makerbase-mks/MKS-SERVO57C/Shell file/shell-1.STL

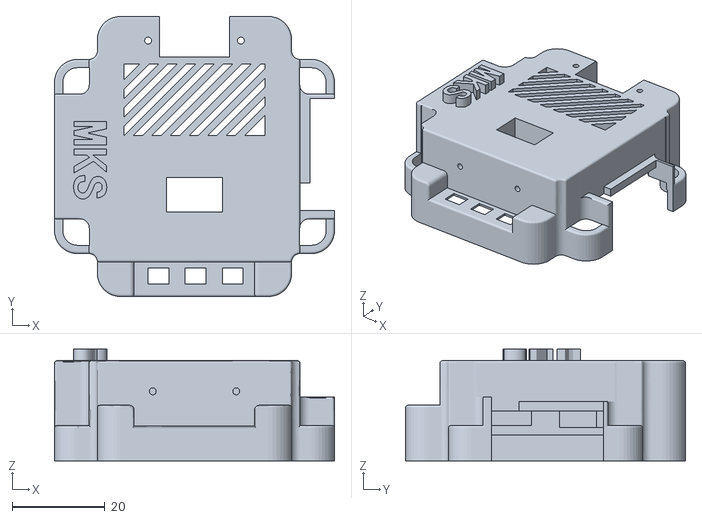
[picture p1: CAD file, 2022-12-19]
Shell file/shell-1.STL
60.4 x 60.4 x 24.1
