makerbase-mks/MKS-SERVO57C/Shell file/shell-2.STL

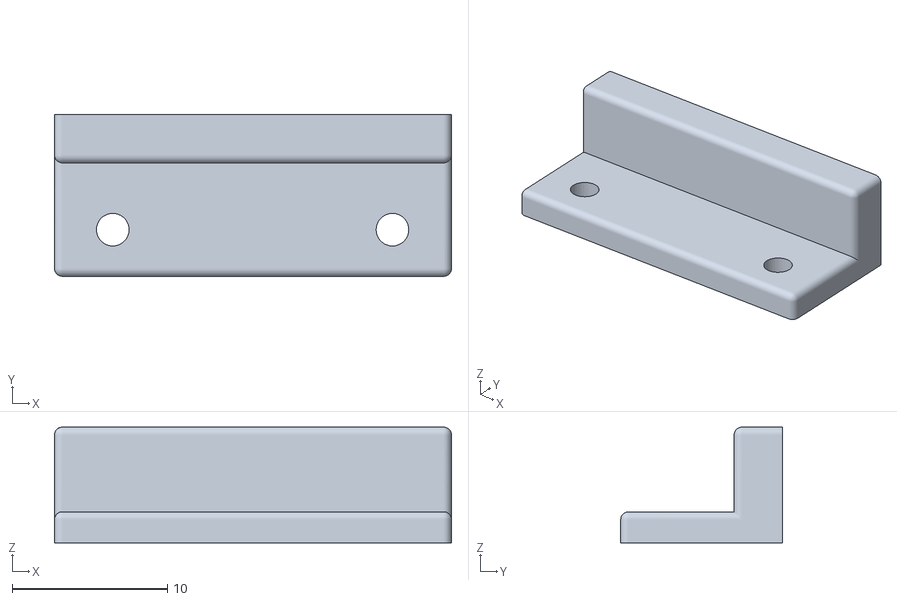
[picture p2: CAD file, 2022-12-19]
Shell file/shell-2.STL
25.6 x 10.4 x 7.45
