makerbase-mks/MKS-SERVO57C/Shell file/shell-3.STL

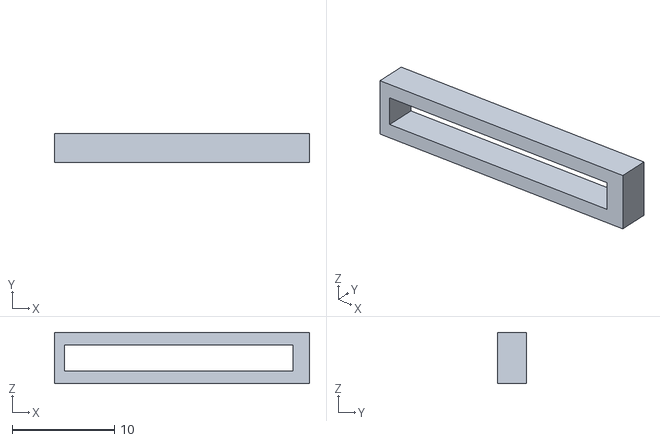
[picture p3: CAD file, 2022-12-19]
Shell file/shell-3.STL
25.0 x 2.80 x 5.00
