makerbase-mks/MKS-SERVO57C/Shell file/shell-4.STL

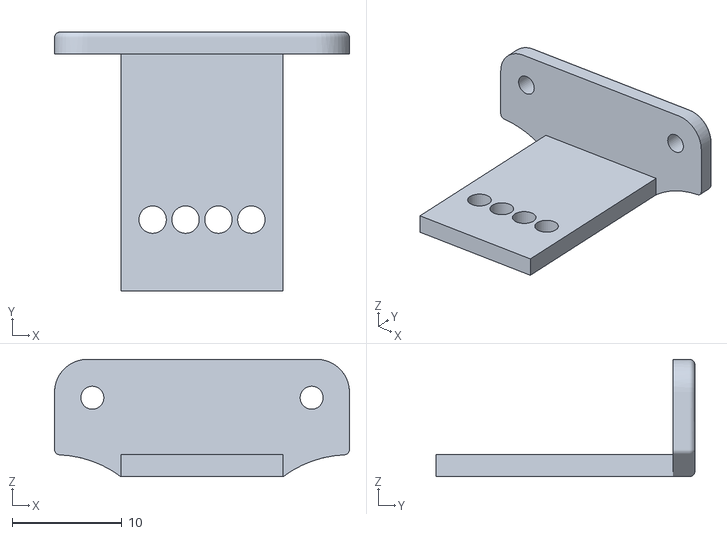
[picture p4: CAD file, 2022-12-19]
Shell file/shell-4.STL
26.9 x 23.6 x 10.7
