makerbase-mks/MKS-SERVO57C/Hardware/MKS SERVO57C Schematic V1.0.1.pdf

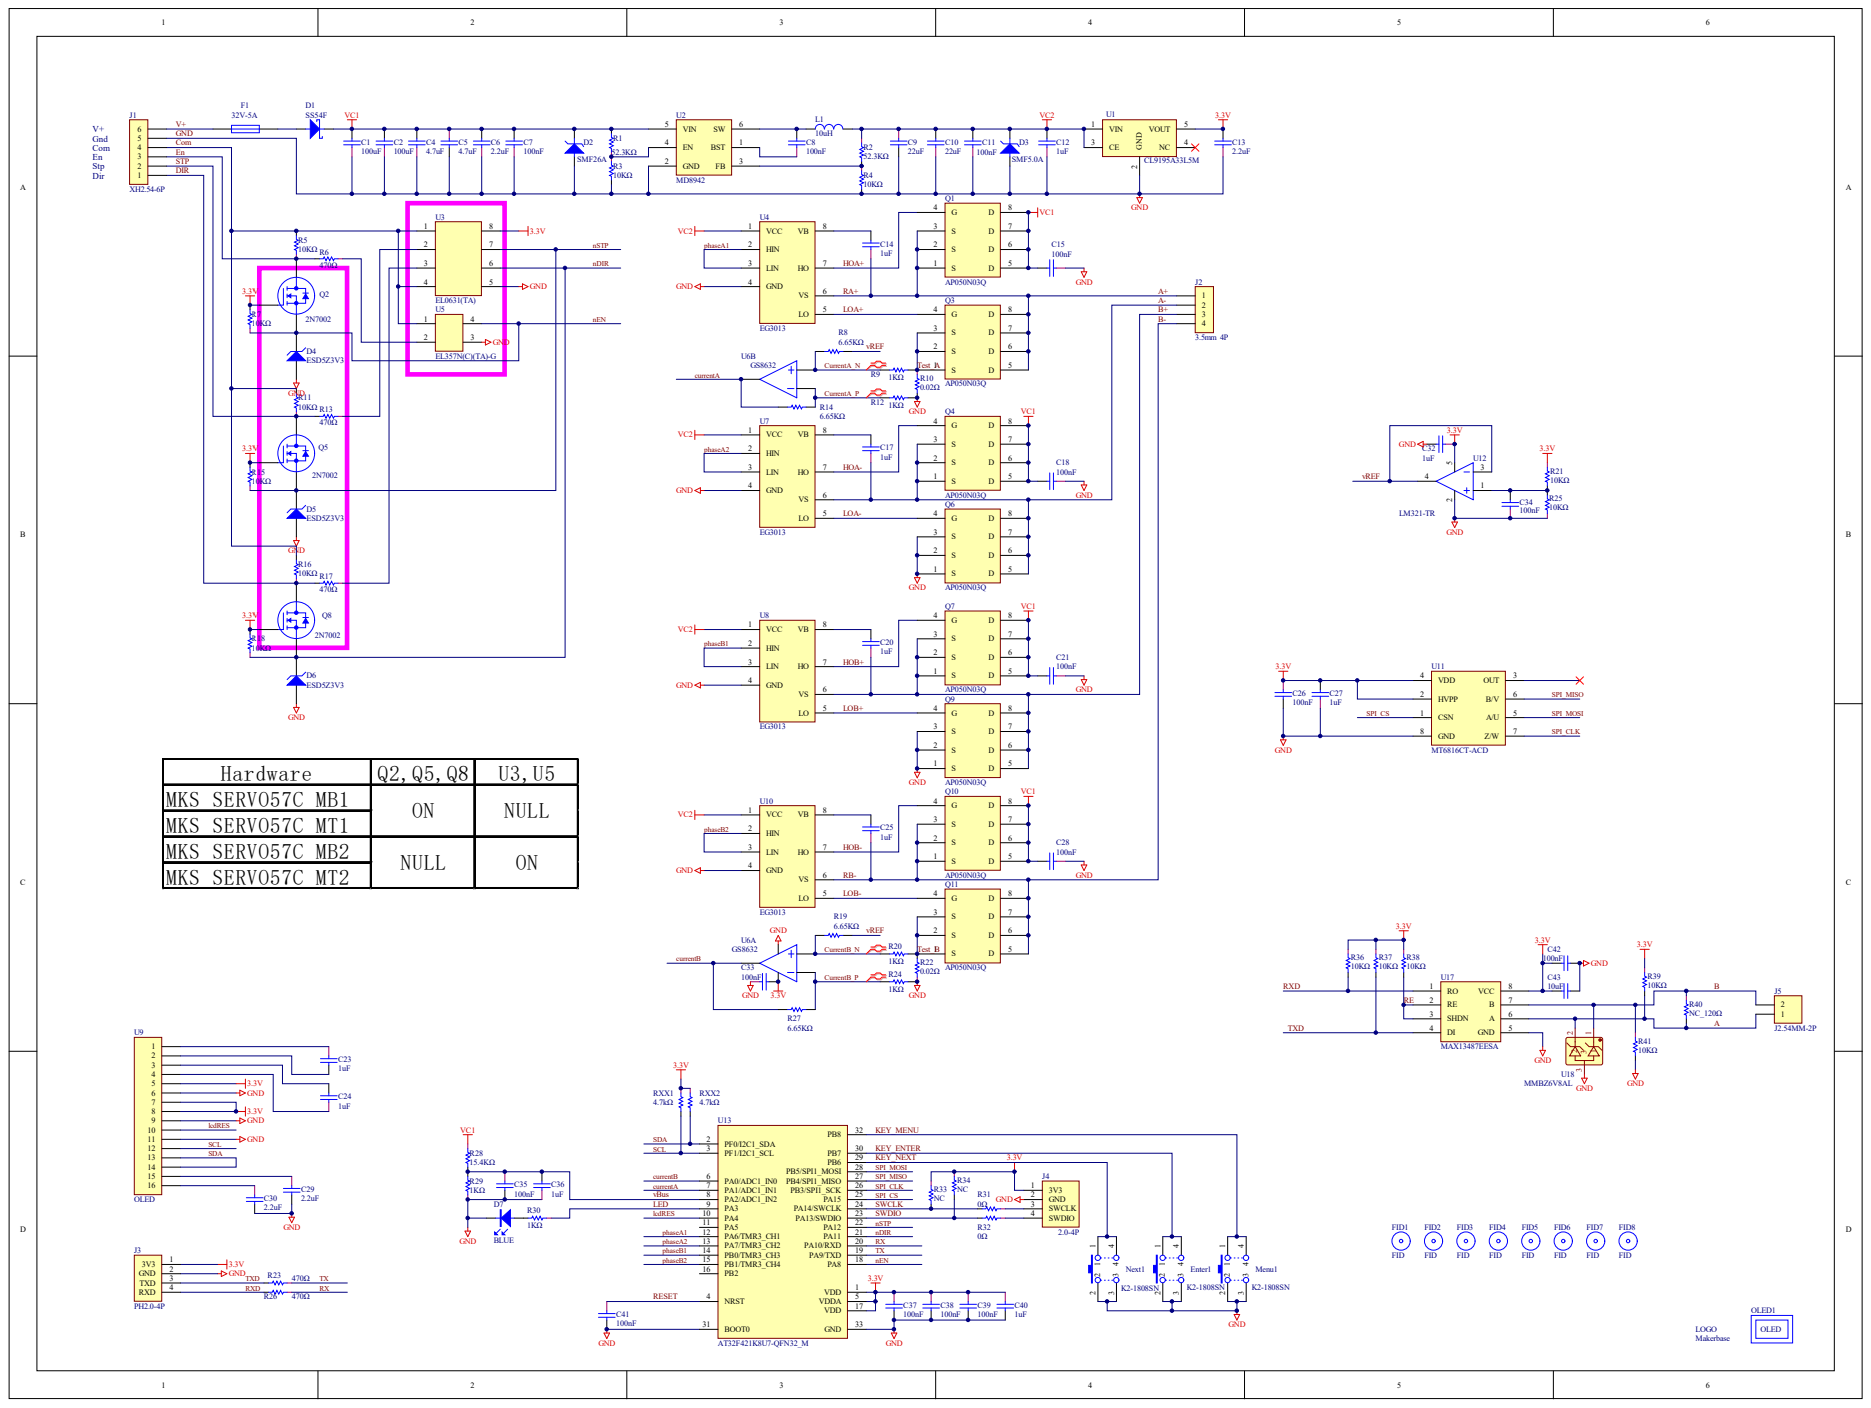
[picture p5: page 1]

HOA+ LOA+ HOB+ HOA- LOA- LOB+ LOB- HOB-

H a r d w a r e | Q 2 , Q 5 , Q 8 | U 3 , U 5
M K S S E R V O 5 7 C M B 1 | O N | N U L L

T est_ 1 B | 5

3 . 3 V
GN D

KEY_ EN T E R
KEY_N E X T 3 . 3 V
S P I_M O S I
