makerbase-mks/MKS-SERVO57C/(threads)

Thread 1 (2023-01-02):

MKS-SERVO57C shifting problems

gs1960, 2023-01-02:
Hello guys,
in my custom printer, with Duet2 WiFi and RepRap 3.4.4 firmware I replaced the old SERVO-57A because one was broken, with the new SERVO-57C.
Unfortunately I can't print anymore and I have constant shifting problems.
In 57A there were few parameters, in 57C there are many and I don't know what to change to solve this problem....could someone help me please?
I set the same things I had in A:
microstep 32 (tryed 16, 64 and 128 too)
current 1600
pin enabled
dir CW
In A there are no other settings....it was easy.
But here are some pictures of the results:
https://ae02.alicdn.com/kf/Aecf21c5940bb4afea1e8d762c333cb55j.jpg
https://ae02.alicdn.com/kf/Af1ee6849ce9f4f39b336f917bab4fcb3W.jpg
https://ae02.alicdn.com/kf/A537fabe9bd834938abe998e325a5a07cE.jpg

mozg4D, 2023-07-13:
ok, must admit, I was wrong, set EN in menu to "hold" and adjust current in MA. high currents are ok for VFOC if system is reasonably loaded. if motor temperature stays below 80 degrees motor would be fine.

Thread 2 (2023-01-15):

Source code and 0.9 degree stepper support

kutukvpavel, 2023-01-15:
Hi there!

Nice to see Servo57 get a new HW revision, hope it brings the same control algorithm improvements revision C brought to Servo42. I've been using Servo57A for a while now, and having easy access to source code and being able to edit it really comes in handy sometimes. So, how about open-sourcing this revision too?

For example, current user manual for rev.C doesn't mention 0.9 degree stepper support at all, and there's no item in the menu to choose step size (as there was for Servo42, for example). This is true for rev.A also. However, for rev.A I've been able to look though the sources and find that the driver measures step size on its own (in StepperCtrl::begin), and there is a manual setting of steps/rev in the USB console as well.

As for rev.C, I'm left wondering, what's the state of 0.9 degree step support? And I need an answer fast, because I'm going to order steppers for my new machine in a couple of days. See how the sources (or at least a decent manual) could help me?

Thread 3 (2023-01-29):

Serial Position mode command No Response

dcolcott, 2023-01-29:
Hi There,

I'm controlling the MKS-SERVO57C (V1.0.2 from LCD Display). When I send a Serial Position command (Function 0xFD) the motor runs at the correct speed, acceleration and number of pulses but there is no serial response to the command.

I only have documentation for v1.0.1 (is there a link to updated documentation?) but as per that I expect to get a run starting and run complete serial message response. All other functions returning the expected serial response but after the serial position command there is no Serial response bytes at all.

Thread 4 (2024-03-05):

CR_vFOC mode (magnet loss!)

itSinock, 2024-03-05:
I use Nama 23 57CM13-3A  When I want to select CR_vFOC mode, it shows "magnet loss!" and "wrong protect!" error How should I solve this problem so that I can use the features of this mode?and i want to know what's the magnet and protect exactly in this error?
Tnx

    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

Closed 2024-03-07.

Thread 5 (2024-10-18):

"COM" Connection for MB1 Model

sseken, 2024-10-18:
Hi, there.

I am using the MB1 (Suit1) model of the SERVO57C.  The "MKS SERVO57C Product Interface" diagram on your website (https://makerbase3d.com/product/makerbase-servo57c-pcba/) specifies connecting "COM" to "3.3V / 5V" for the photocoupler version (MB2, Suit2).  Could you please clarify where "COM" should be connected for the MB1 model? During my testing, both connecting to "GND" and leaving it "Floating" seemed to work without issues.

I also checked the online manual (https://github.com/makerbase-mks/MKS-SERVO57C/blob/main/User%20Manual/MKS%20SERVO57C%20User%20Manual%20V1.0.2.pdf) but could not find the detailed information. Thank you in advance for your kind help.
